rt-net/JetsonNanoMouse_Hardware/3d_cad_data/README.md

# 3D CADデータ集

Jetson Nano Mouseやオプションパーツの3Dモデルデータを公開しています。

## JetsonNanoMouseV1_with_wheel.stp

Jetson Nano Mouse本体の3Dモデルデータです。

## jnmouse_lidar_mount_rev20210329.stl

Jetson Nano Mouse オプションキットNo.1（[マルチLiDARマウント](https://rt-net.jp/products/jetson-nano-mouse/#option-01)）の3Dモデルデータです。
