rt-net/JetsonNanoMouse_Hardware/3d_cad_data/jnmouse_lidar_mount_rev20210329.stl

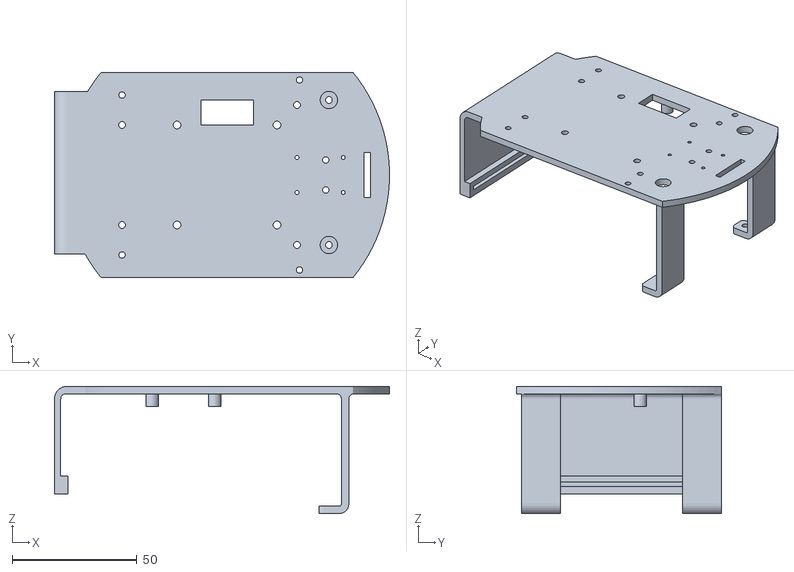
[picture p3: CAD file, 2022-08-04]
3d_cad_data/jnmouse_lidar_mount_rev20210329.stl
134.0 x 82.1 x 51.0
