rt-net/JetsonNanoMouse_Hardware/circuit_diagram/JetsonNanoMouse-v1-20210215.pdf

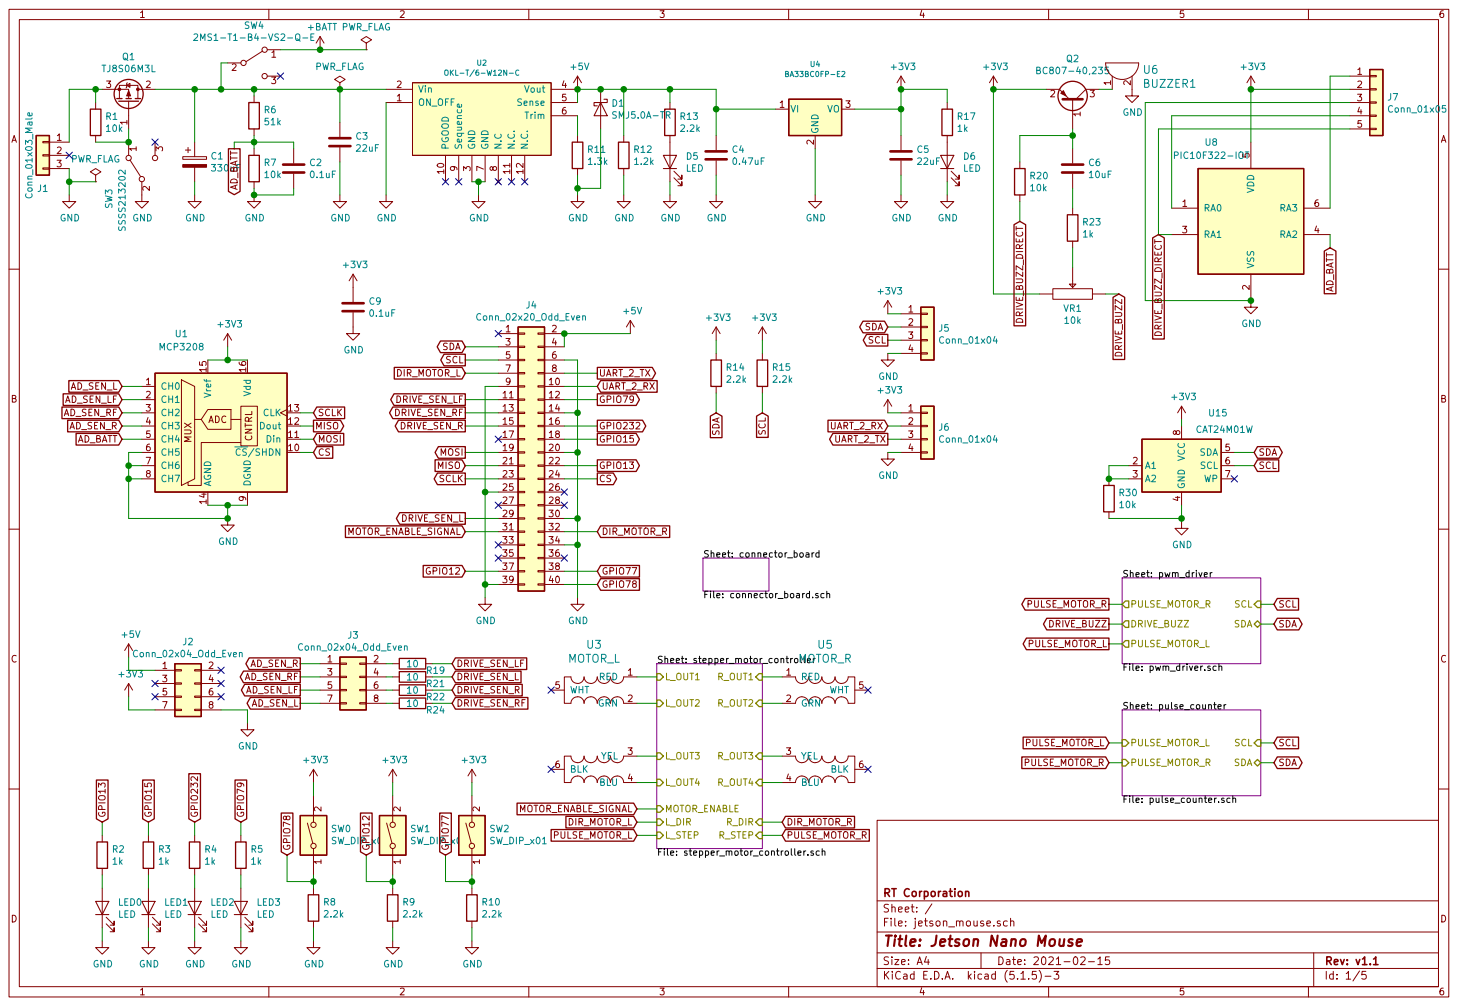
[picture p5: page 1]

2 VO 3 U4 BA33BC0FP-E2 RED 1 GRN 2 YEL 3 BLU 4 WHT 5 BLK 6 U3 MOTOR_L

3 Vout 4 Sense 5 Trim 6 GND

1 2 SW2 SW_DIP_x01 ADC MUX CNTRL CH0 1 CS/SHDN 10 Din 11 Dout 12 CLK 13 AGND 14 Vref 15 Vdd 16 CH1 2 CH2 3 CH3 4 CH4 5 CH5 6 CH6 7 CH7 8 DGND

11 | 12
13 | 14

4 SDA 5 SCL 6 WP 7 VCC

21 | 22
23 | 24
25 | 26
27 | 28

31 | 32
33 | 34

File: jetson_mouse.sch Sheet: / RT Corporation

Id: 1/5 Title: Jetson Nano Mouse

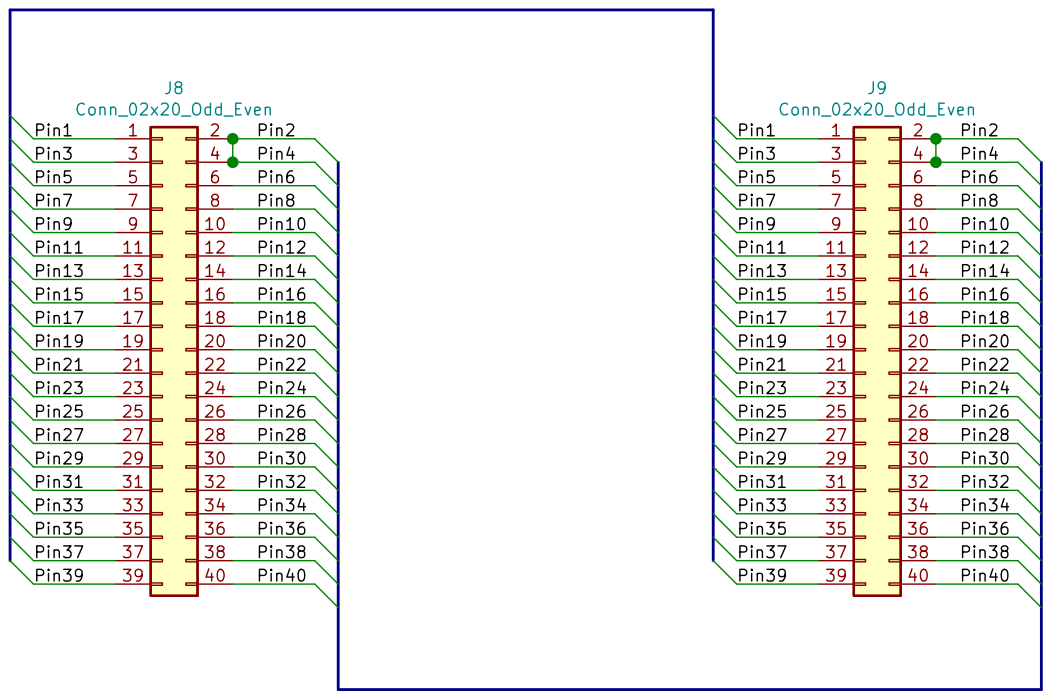
[picture p6: page 2]

RT Corporation
Sheet: /connector_board/
File: connector_board.sch
Id: 2/5 Title: Jetson Nano Mouse

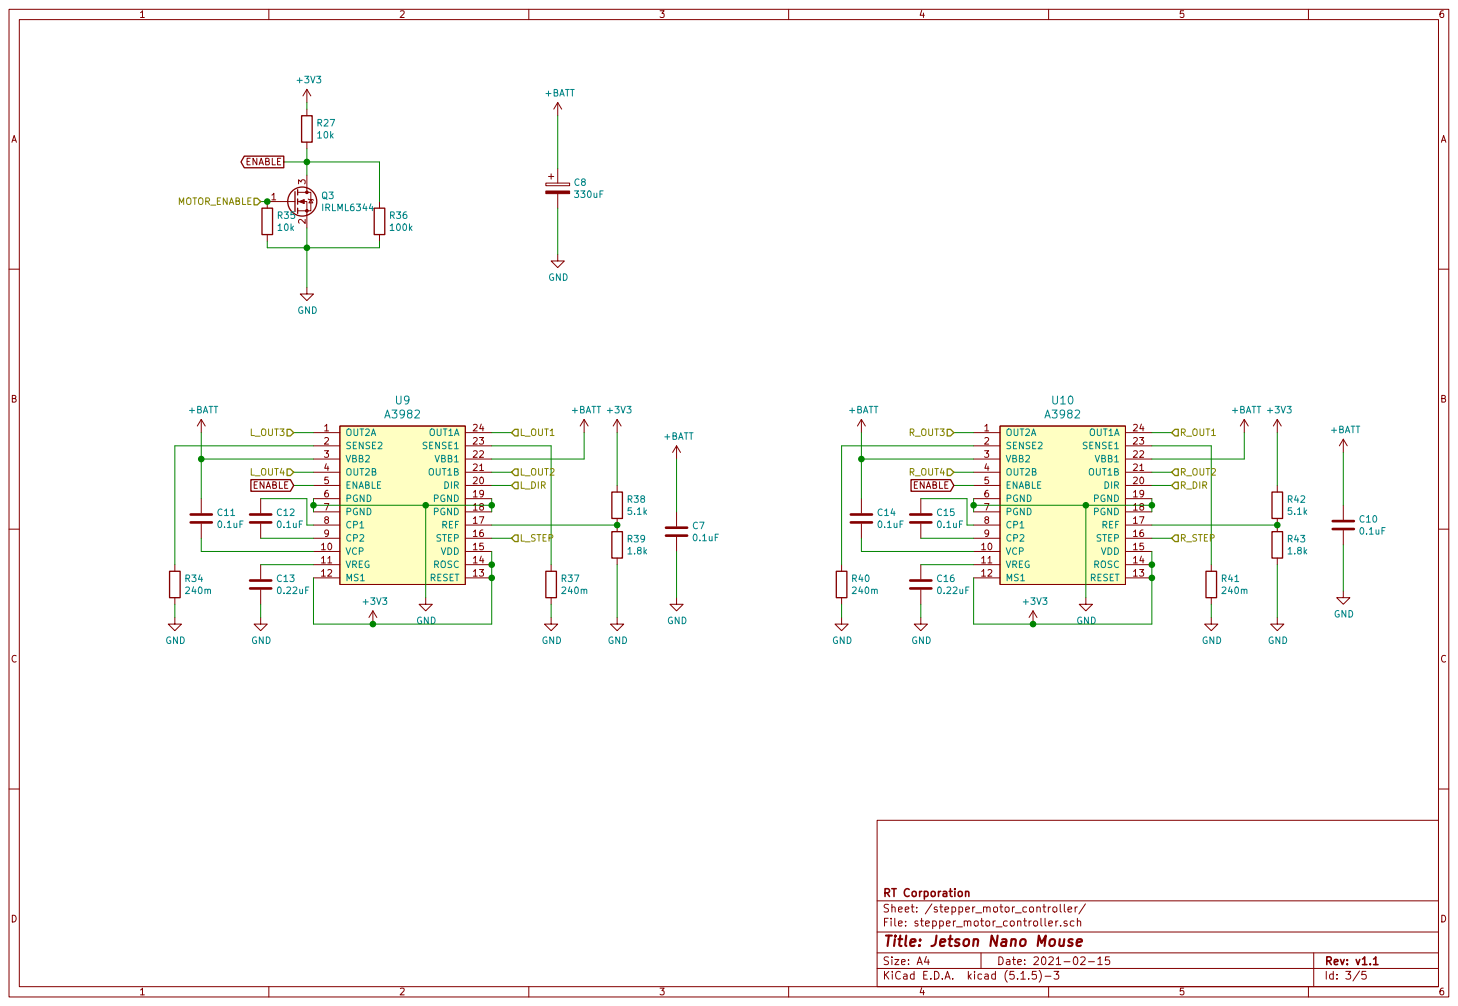
[picture p7: page 3]

RT Corporation
Sheet: /stepper_motor_controller/
File: stepper_motor_controller.sch
Id: 3/5 Title: Jetson Nano Mouse

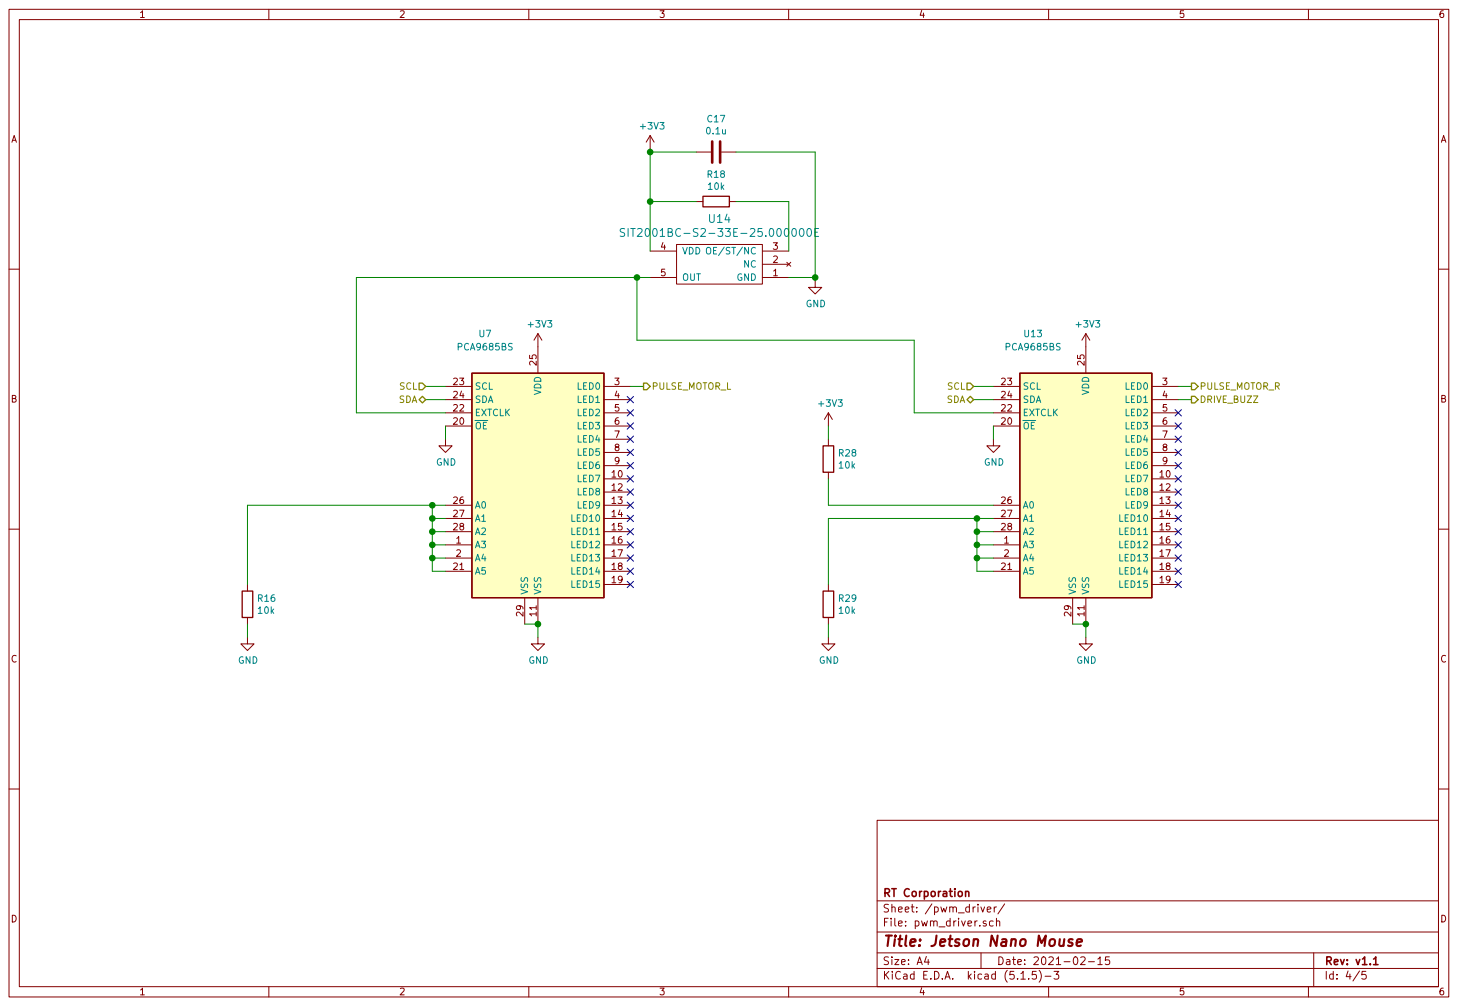
[picture p8: page 4]

Sheet: /pwm_driver/
File: pwm_driver.sch
Id: 4/5 Title: Jetson Nano Mouse

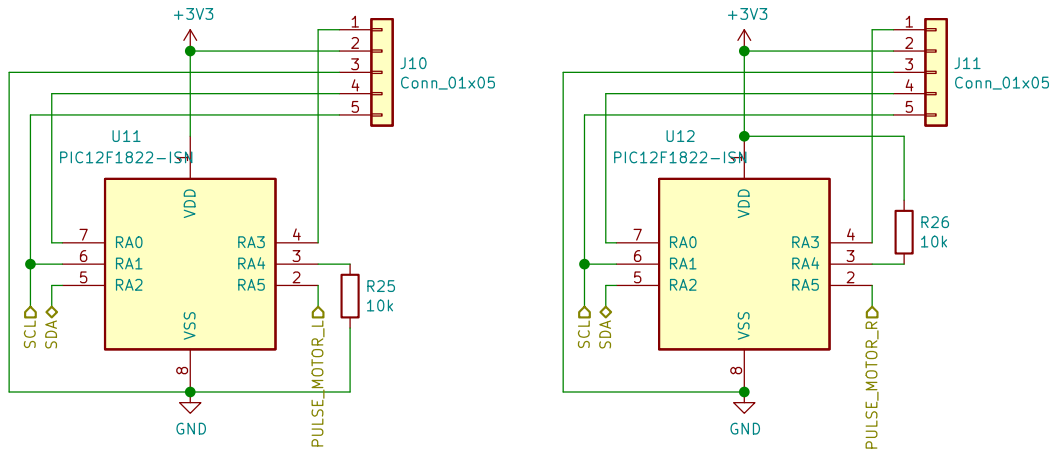
[picture p9: page 5]

Sheet: /pulse_counter/
File: pulse_counter.sch
Id: 5/5 Title: Jetson Nano Mouse
