rt-net/JetsonNanoMouse_Hardware/circuit_diagram/JetsonNanoMouse-v1-20200324.pdf

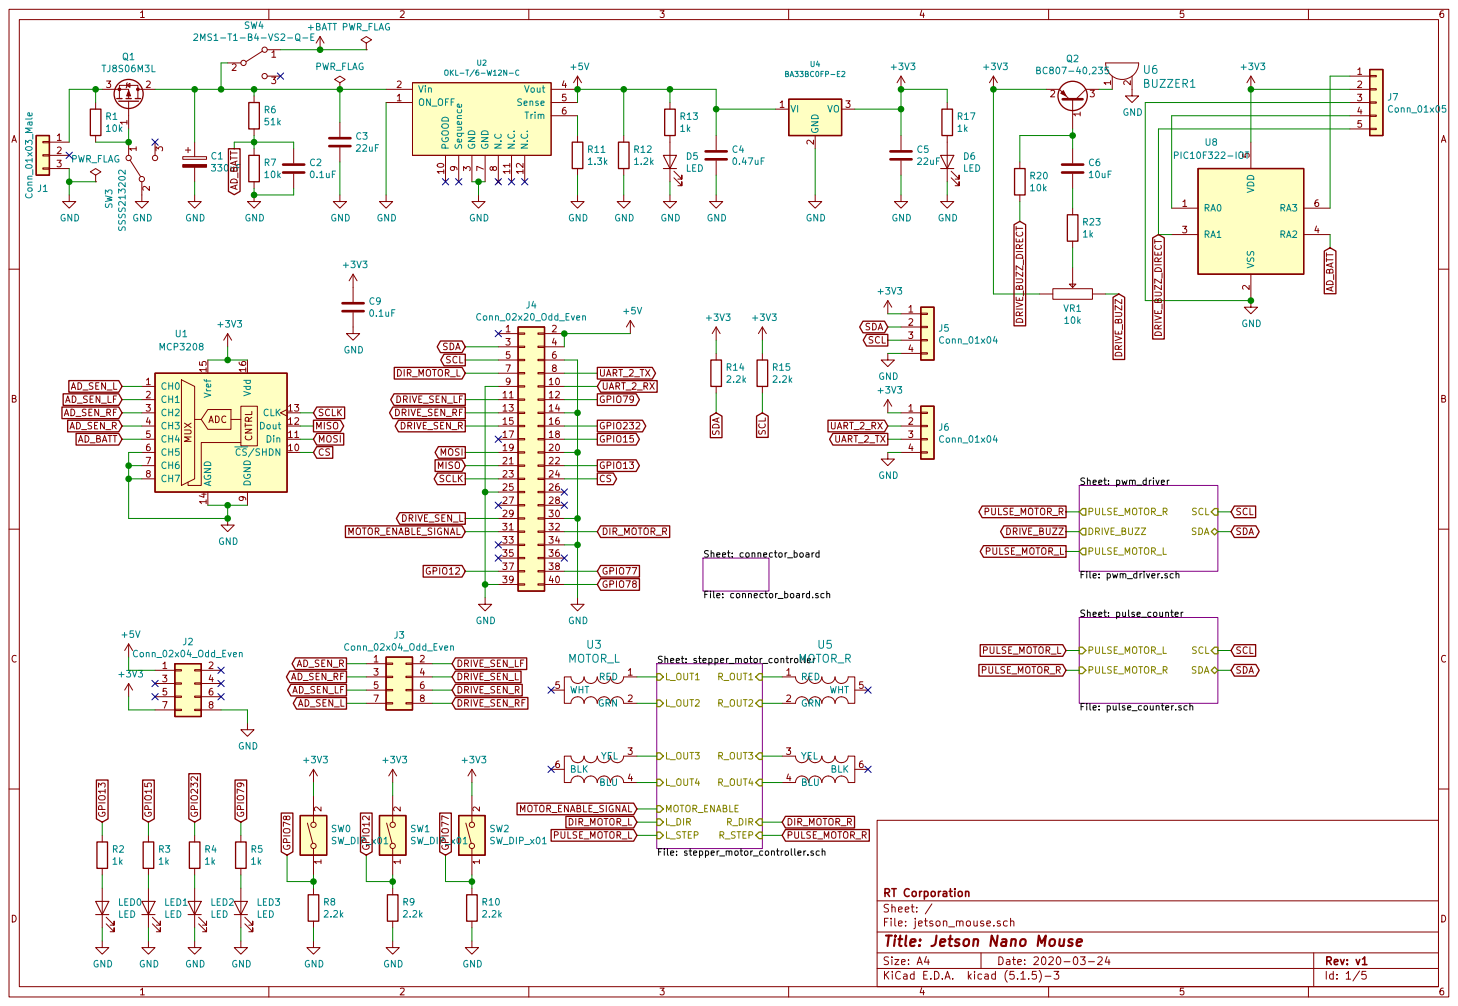
[picture p10: page 1]

3 Vout 4 Sense 5 Trim 6 GND

Sheet: connector_board File: connector_board.sch Sheet: stepper_motor_controller

File: jetson_mouse.sch Sheet: / RT Corporation

Id: 1/5 Title: Jetson Nano Mouse


RT Corporation
Sheet: /connector_board/
File: connector_board.sch
Id: 2/5 Title: Jetson Nano Mouse

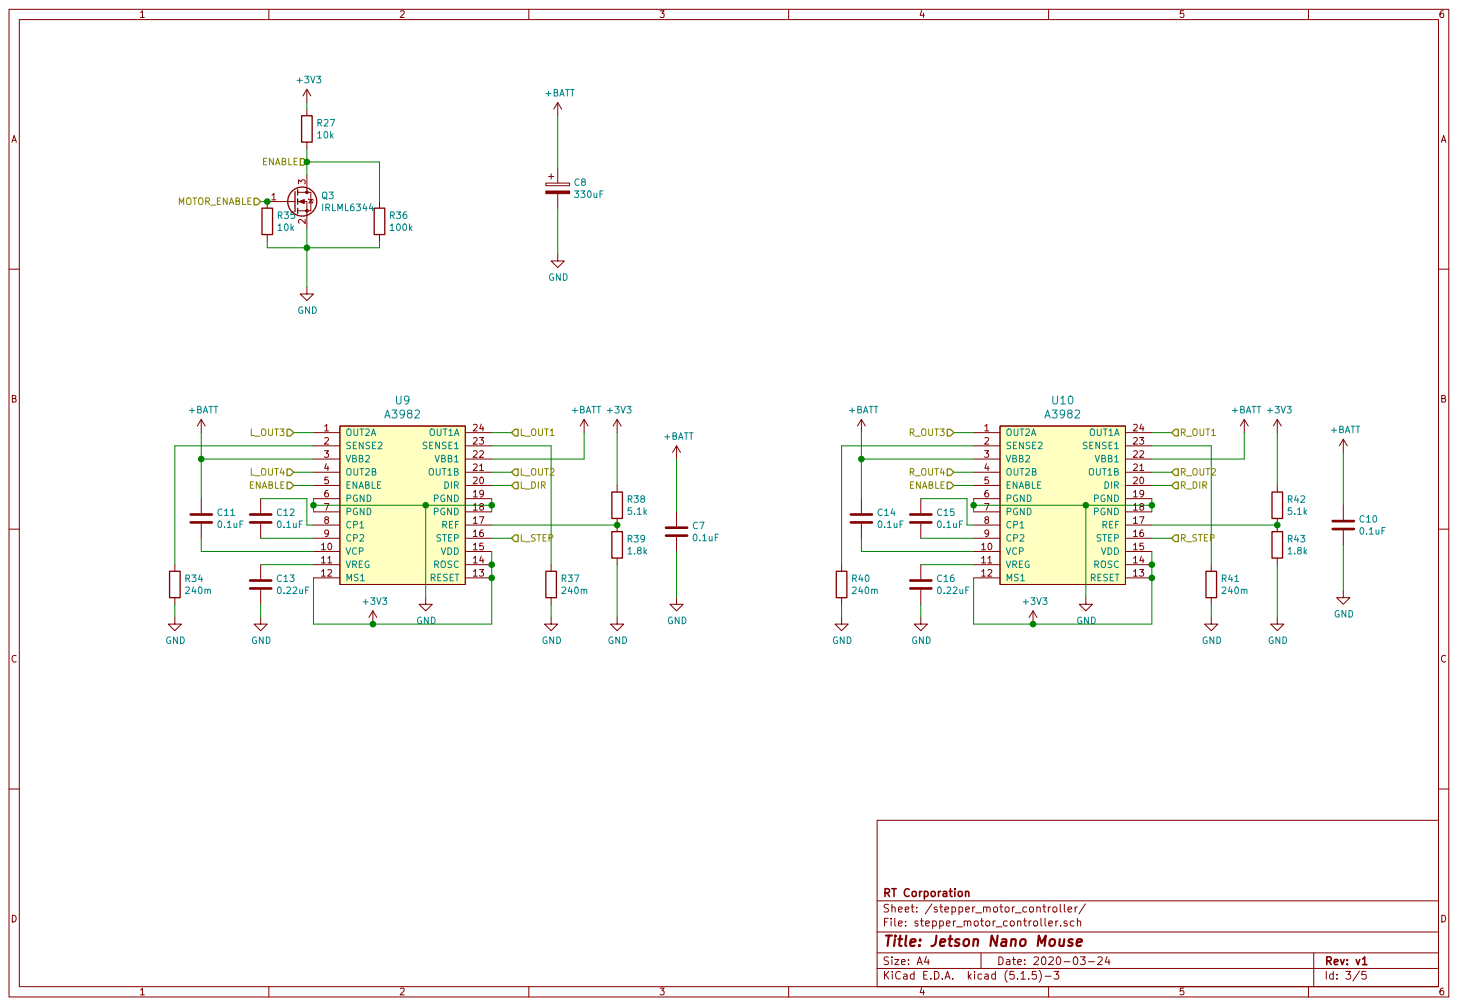
[picture p11: page 3]

RT Corporation
Sheet: /stepper_motor_controller/
File: stepper_motor_controller.sch
Id: 3/5 Title: Jetson Nano Mouse

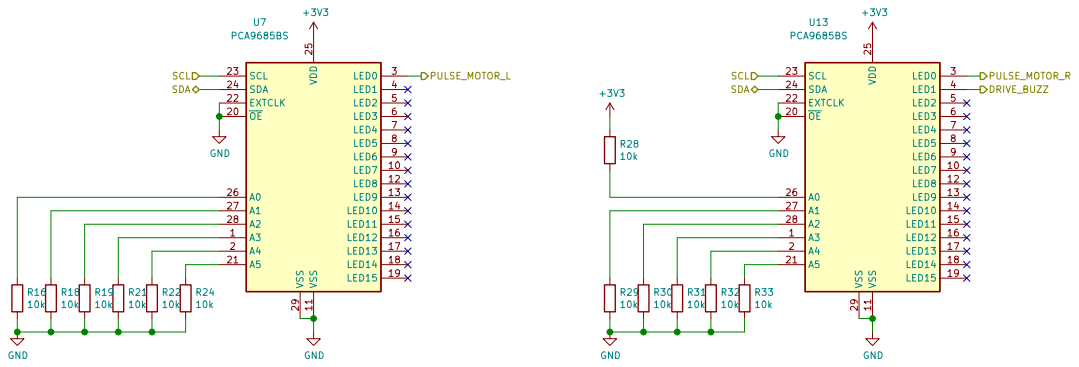
[picture p12: page 4]

Sheet: /pwm_driver/
File: pwm_driver.sch
Id: 4/5 Title: Jetson Nano Mouse


Sheet: /pulse_counter/
File: pulse_counter.sch
Id: 5/5 Title: Jetson Nano Mouse
