rt-net/JetsonNanoMouse_Hardware/(commit log)

2020-10-22 Add STEP data (#3)
    [JetsonNanoMouseV1_with_wheel.stp]
2020-10-22 Organize directory structure (#4)
    [JetsonNanoMouseV1_with_wheel.stp]
2020-11-13 Add Camera information (#5)
2021-03-11 Add Jetson Nano Mouse schematic (#6)
    * Add Jetson Nano Mouse schematic
    * Update README
2021-11-09 Add description about wheel (#8)
    * Add description about wheel
    * Fix spacing
2021-11-09 Fix connector-board position (#7)
    [JetsonNanoMouseV1_with_wheel.stp]
2021-11-16 Update Jetson Nano Mouse schematic (#9)
    * Add circuit_diagram README
    * Fix typo
    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
2022-08-04 Add LiDAR mount 3D model data (#10)
    [jnmouse_lidar_mount_rev20210329.stl]
